matt001k/ANIMIO/ANIMAPP/OBJECTS/Home.png

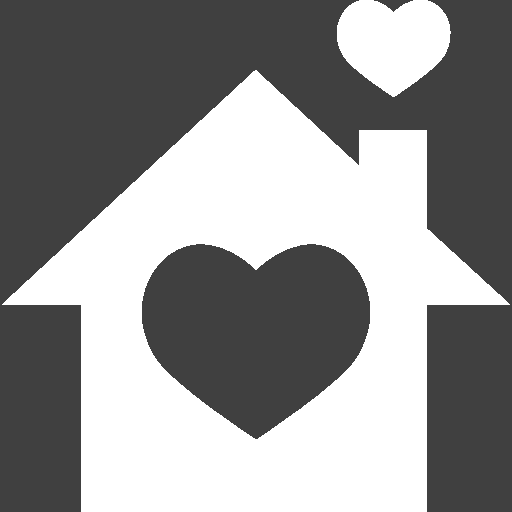
ANIMAPP/OBJECTS/Home.png
