matt001k/ANIMIO/ANIMAPP/OBJECTS/Phone.png

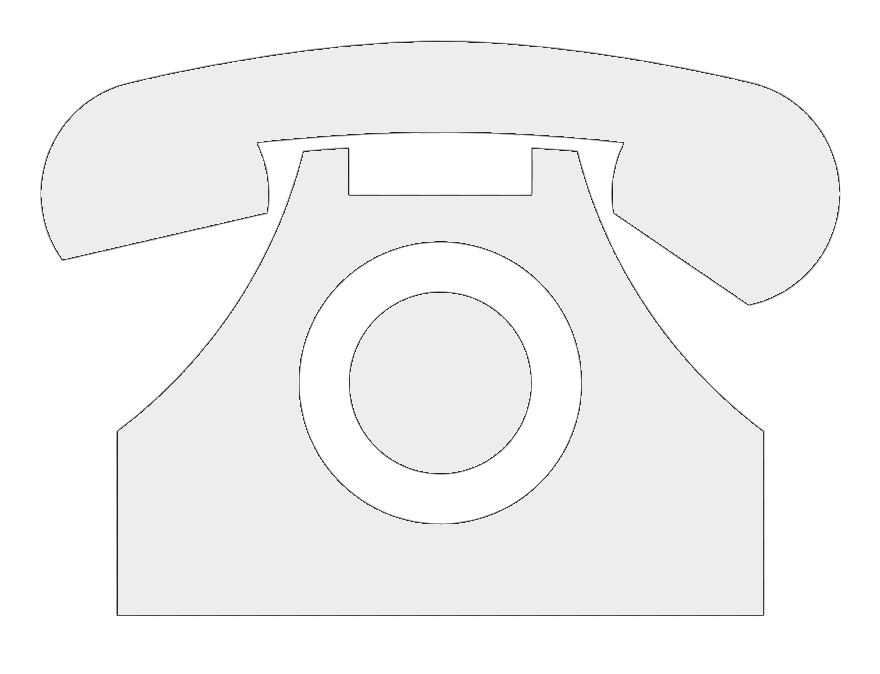
ANIMAPP/OBJECTS/Phone.png
