matt001k/ANIMIO/ANIMAPP/OBJECTS/Settings.png

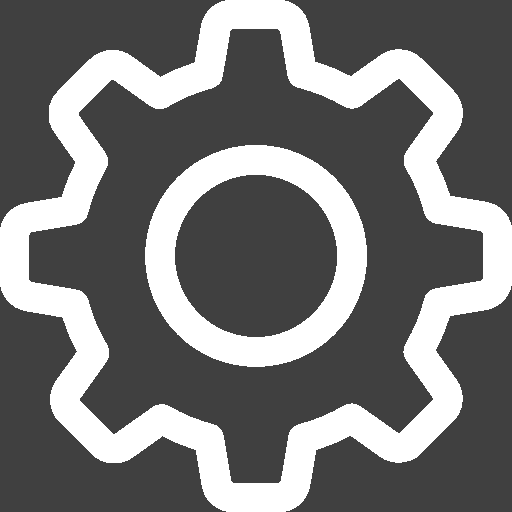
ANIMAPP/OBJECTS/Settings.png
