matt001k/ANIMIO/Images/Libraries.PNG

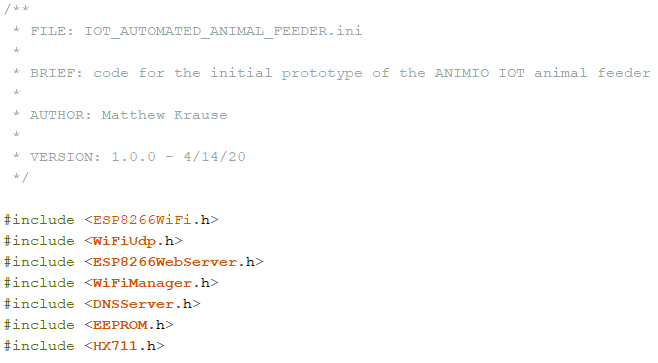
Images/Libraries.PNG
