matt001k/ANIMIO/Images/valve assem.jpg

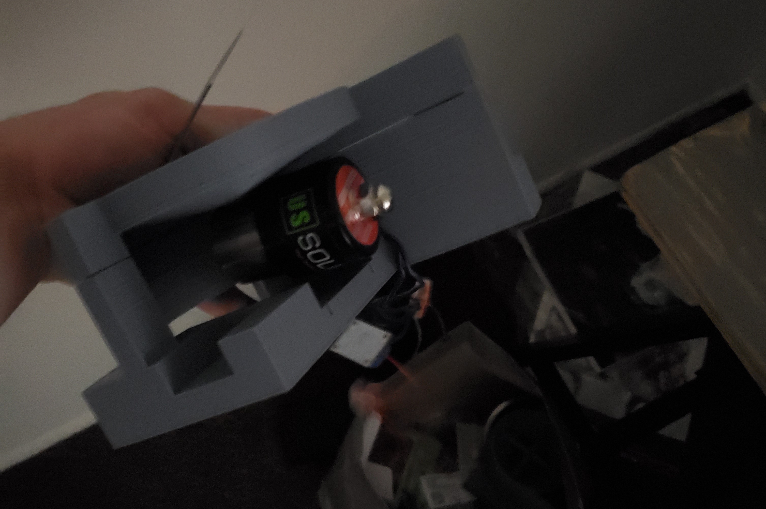
Images/valve assem.jpg
