matt001k/ANIMIO/Materials/Bill of Materials(ANIMIO).pdf

Assembly Name : Components List Approval Date :
Part Count : | 13
Total Cost : | $119.51
Part # | Part Name | Description | Qty | Manufacturer | Website Link: | Documentation | Unit Cost | Cost
SEN-13329 | Load Cell | 40-50kg max load | 2 | SparkFun | https://www.digikey.com/pr oduct-detail/en/sparkfun- (https://www.digikey.com/product-detail/en/sparkfun-electronics/SEN-13329/1568-1852-ND/7393715)
$ | 8.50 | $ 17.00
WRL-13804 | SparkFun ESP8266 Thing -Dev Board(With Headers) | Designed around ESP8266 Microcontroller | 1 | SparkFun | https://www.digik (https://www.digikey.com/product-detail/en/sparkfun-electronics/SEN-13329/1568-1852-ND/7393715)ey.com/pr oducts/en?keywords=WRL- (https://www.digikey.com/products/en?keywords=WRL-13804)
$ | 17.95 | $ 17.95
FIT0495-G | Geared Motor | 6V, 162RPM, 1.2Kg/Cm | 1 | DFRobot | https:/ (https://www.digikey.com/products/en?keywords=WRL-13804)/www.digikey.com/pr
oduct- (https://www.digikey.com/product-detail/en/dfrobot/FIT0495-G/1738-1285-ND/7087182)
$ | 10.00 | $ 10.00
JFSV00065 | Solenoid Valve | Stainless Steel, 1/4" inlet and outlet port, 12VDC | 1 | USSOLID | https://www.amazon.com/ (https://www.digikey.com/product-detail/en/dfrobot/FIT0495-G/1738-1285-ND/7087182)U- S-Solid-Stainless-Electric- (https://www.amazon.com/U-S-Solid-Stainless-Electric-Solenoid/dp/B00APD49BS)
$ | 28.00 | $ 28.00
ROB-14450 | Motor Driver Board | TB6612FNG IC, PWM Control | 1 | SparkFun | https://www.digikey.com/pr (https://www.amazon.com/U-S-Solid-Stainless-Electric-Solenoid/dp/B00APD49BS) oduct-detail/en/sparkfun- (https://www.digikey.com/product-detail/en/sparkfun-electronics/ROB-14450/1568-1755-ND/7915576)
$ | 5.45 | $ | 5.45
SEN-13879 | HX711 Load Cell Amplifier | Module designed around HX711 | 2 | SparkFun | https://www.digik (https://www.digikey.com/product-detail/en/sparkfun-electronics/ROB-14450/1568-1755-ND/7915576)ey.com/pr oduct-detail/en/sparkfun- (https://www.digikey.com/product-detail/en/sparkfun-electronics/SEN-13879/1568-1436-ND/6202732)
$ | 9.95 | $ 19.90
L6R36-120 | Power Supply | 12V,36W,Wall Mounted | 1 | Tri-Mag, LLC | https://www.digik (https://www.digikey.com/product-detail/en/sparkfun-electronics/SEN-13879/1568-1436-ND/6202732)ey.com/pr oduct-detail/en/tri-mag- (https://www.digikey.com/product-detail/en/tri-mag-llc/L6R36-120/364-1282-ND/7682645)
$ | 10.16 | $ 10.16
PJ-202AH | DC Power Jack Male | Rated 5A,24Vdc | 1 | CUI Devices | https://www.digikey.com/ (https://www.digikey.com/product-detail/en/tri-mag-llc/L6R36-120/364-1282-ND/7682645)pr oduct-detail/en/cui- (https://www.digikey.com/product-detail/en/cui-devices/PJ-202AH/CP-202AH-ND/408450)
$ | 0.74 | $ | 0.74
COM-15208 | Buck-Boost Converter | 3-16V Input, 2.5-9V Output, 2A Output Current | 1 | SparkFun | https://www.digikey.com (https://www.digikey.com/product-detail/en/cui-devices/PJ-202AH/CP-202AH-ND/408450)/pr oduct-detail/en/sparkfun- (https://www.digikey.com/product-detail/en/sparkfun-electronics/COM-15208/1568-COM-15208-ND/10187090)
$ | 10.31 | $ 10.31
VMA-406 | Relay | 5V Input, 120VAC Output,SPDT
1 | Velleman | Currently On hand | $ | -
VMA-301 | Real Time Clock | With Backup Battery | 1 | Velleman | Currently On hand | $ | -
$ | -
$ | -
$ | -
$ | -
$ | -
$ | -
$ | -
$ | -
| Total | | 13 | | | | | $ 119.51

# IOT Automated Animal Feeder

FIT0495-G_Web.pdf Solenoid Valve Data.JPG TB6612FNG Datasheet.pdf | TB6612FNG Hookup Guide.pdf SparkFun_HX711_Load_Cell_v11.pdf | hx711_english.pdf ESP8266ThingDevV1.pdf | L6R36-L6R48 Series Datasheet.pdf PJ-202AH Datasheet.pdf COM-15208 Datasheet.pdf | TPS63070 Datasheet.pdf | Buck-Boost_Hookup_Guide_.pdf vma406 Datasheet.pdf vma301 Datasheet.pdf | ds1302 Datasheet.pdf
