matt001k/ANIMIO/Materials/Datasheets/JFSV00065 - Solenoid Valve/Solenoid Valve Data.JPG

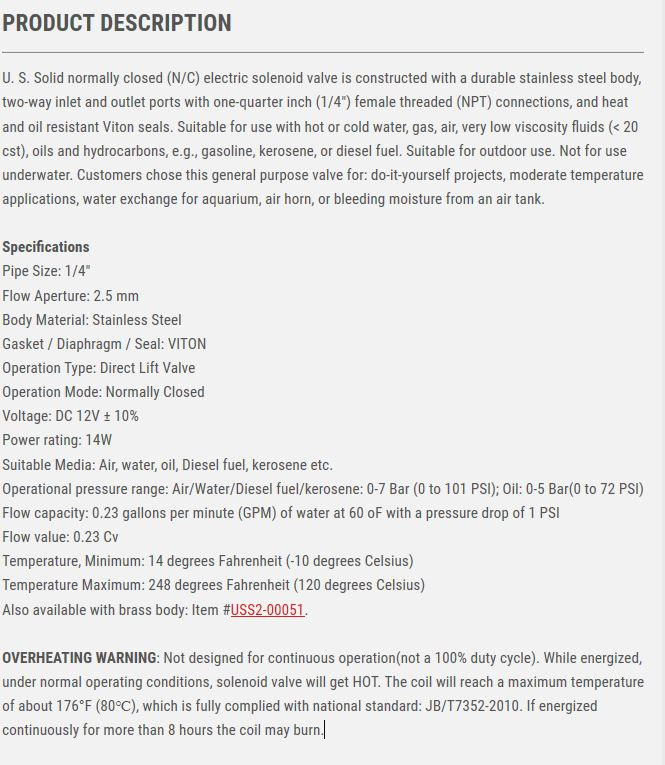
Materials/Datasheets/JFSV00065 - Solenoid Valve/Solenoid Valve Data.JPG
