matt001k/ANIMIO/Schematics/Mechanical Schematics/001003M(ANIMIO ASSEMBLY).pdf

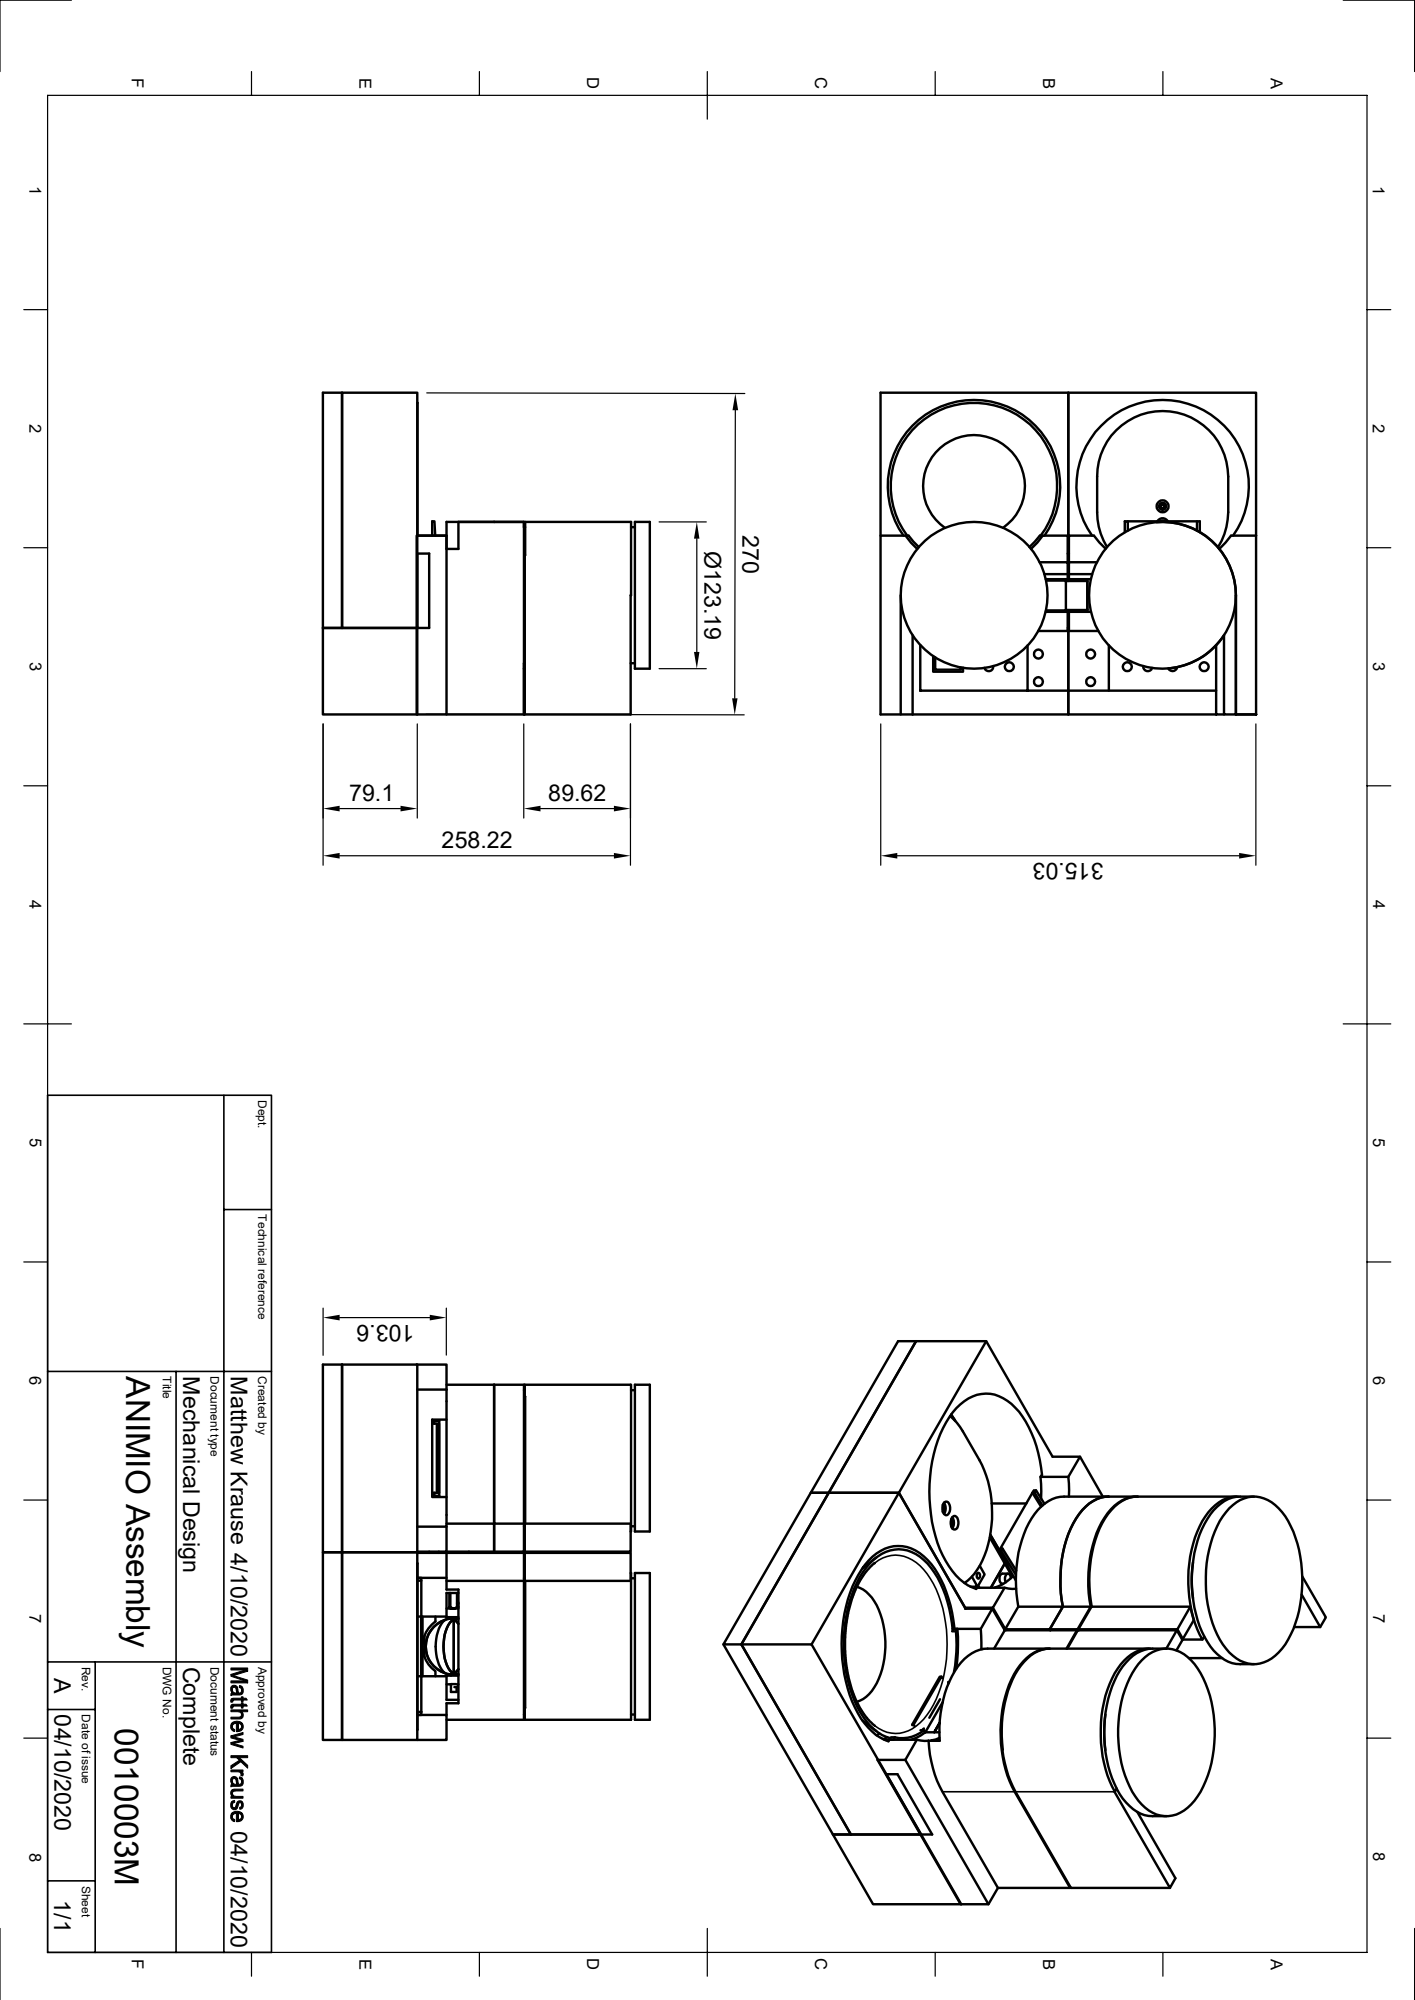
[picture p25: page 1]

1 A 2 3 4 5 6 7 8 1 2 3 4 5 6 7 8 FEDCB FEDCBA Dept. Technical reference Created by Approved by Title DWG No. Document type Document status Rev. Date of issue Sheet 04/10/2020 AComplete Mechanical Design 04/10/2020 4/10/2020 1/1 0010003M ANIMIO Assembly Matthew Krause
