matt001k/ANIMIO/Schematics/Electrical Schematics/999810(IOT AUTOMATED ANIMAL FEEDER)-REV B.pdf

L
N

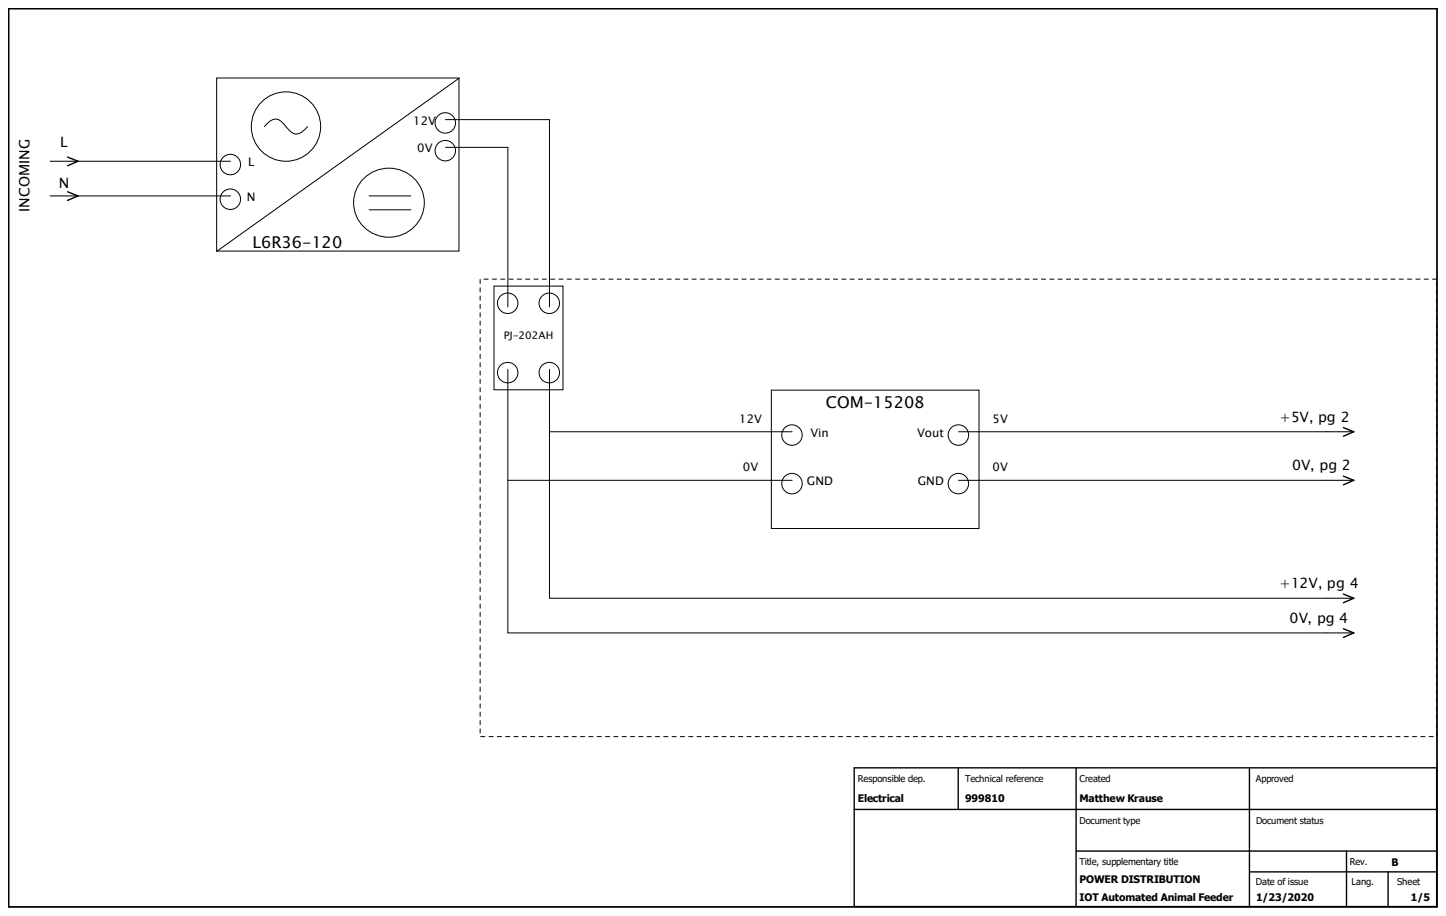
[picture p26: page 1]
N INCOMING; Vin; GND; Vout; COM-15208; Responsible dep. Electrical; Technical reference 999810; Created Matthew Krause; Approved; Document type; Document status

Title, supplementary title POWER DISTRIBUTION IOT Automated Animal Feeder | | Rev. B
Date of issue 1/23/2020 | Lang. | Sheet 1/5

# ESP8266

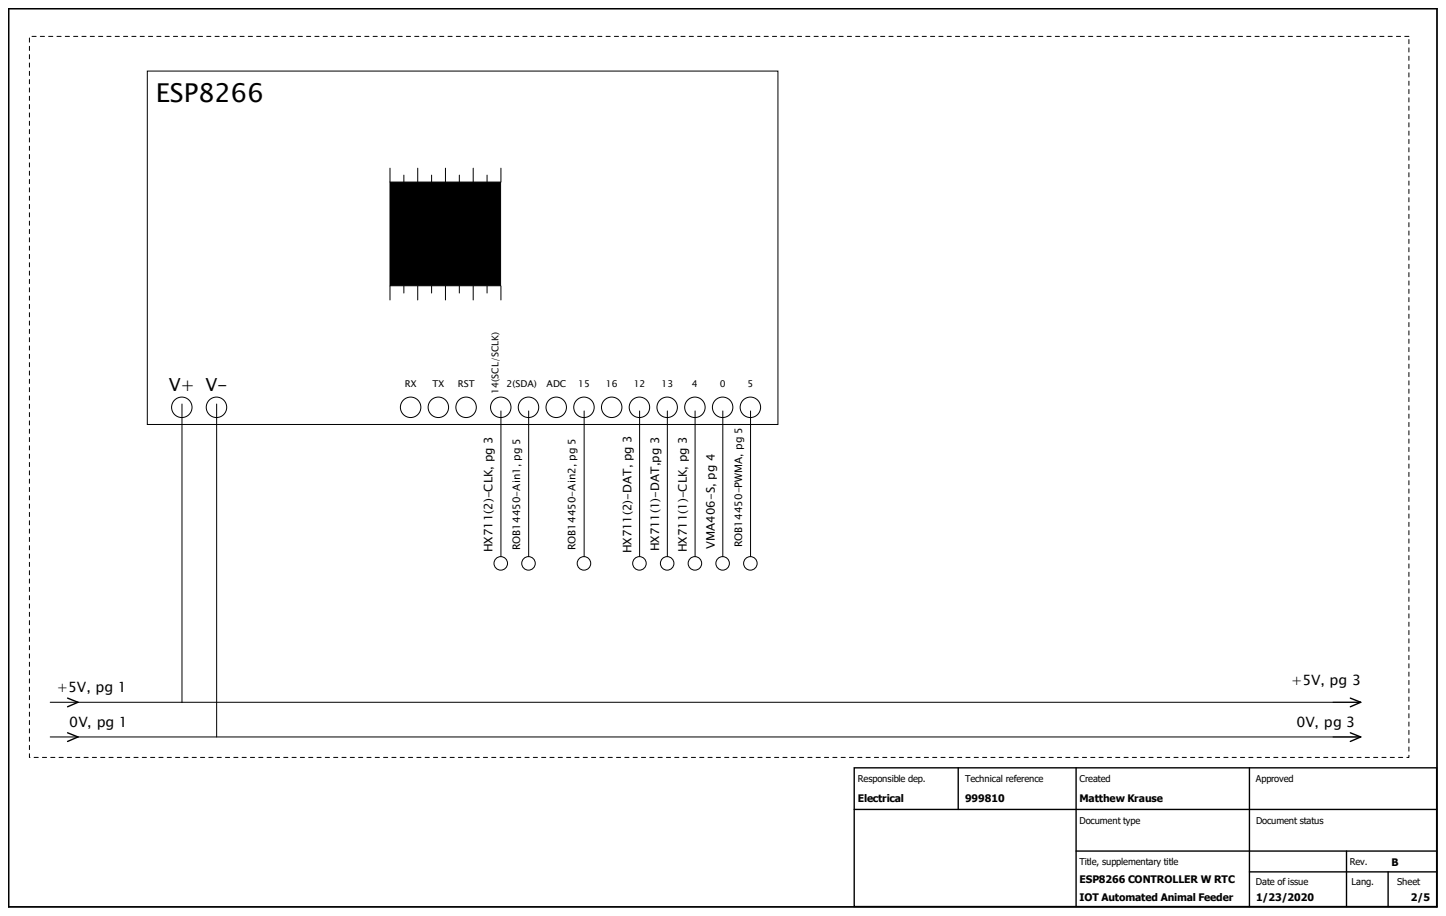
[picture p27: page 2]
0V, pg 3 HX711⁽2⁾-CLK, pg 3; ROB14450-Ain1, pg 5; ROB14450-Ain2, pg 5; HX711⁽2⁾-DAT, pg 3; HX711⁽1⁾-DAT,pg 3; HX711⁽1⁾-CLK, pg 3; VMA406-S, pg 4; ROB14450-PWMA, pg 5; 2(SDA) ADC 15 16 12 13; 5 14⁽SCL/SCLK⁾ RX TX RST; Responsible dep. Electrical; Technical reference 999810; Created Matthew Krause; Approved; Document type; Document status

ESP8266 CONTROLLER W RTC IOT Automated Animal Feeder | Rev. B

### RED BLK

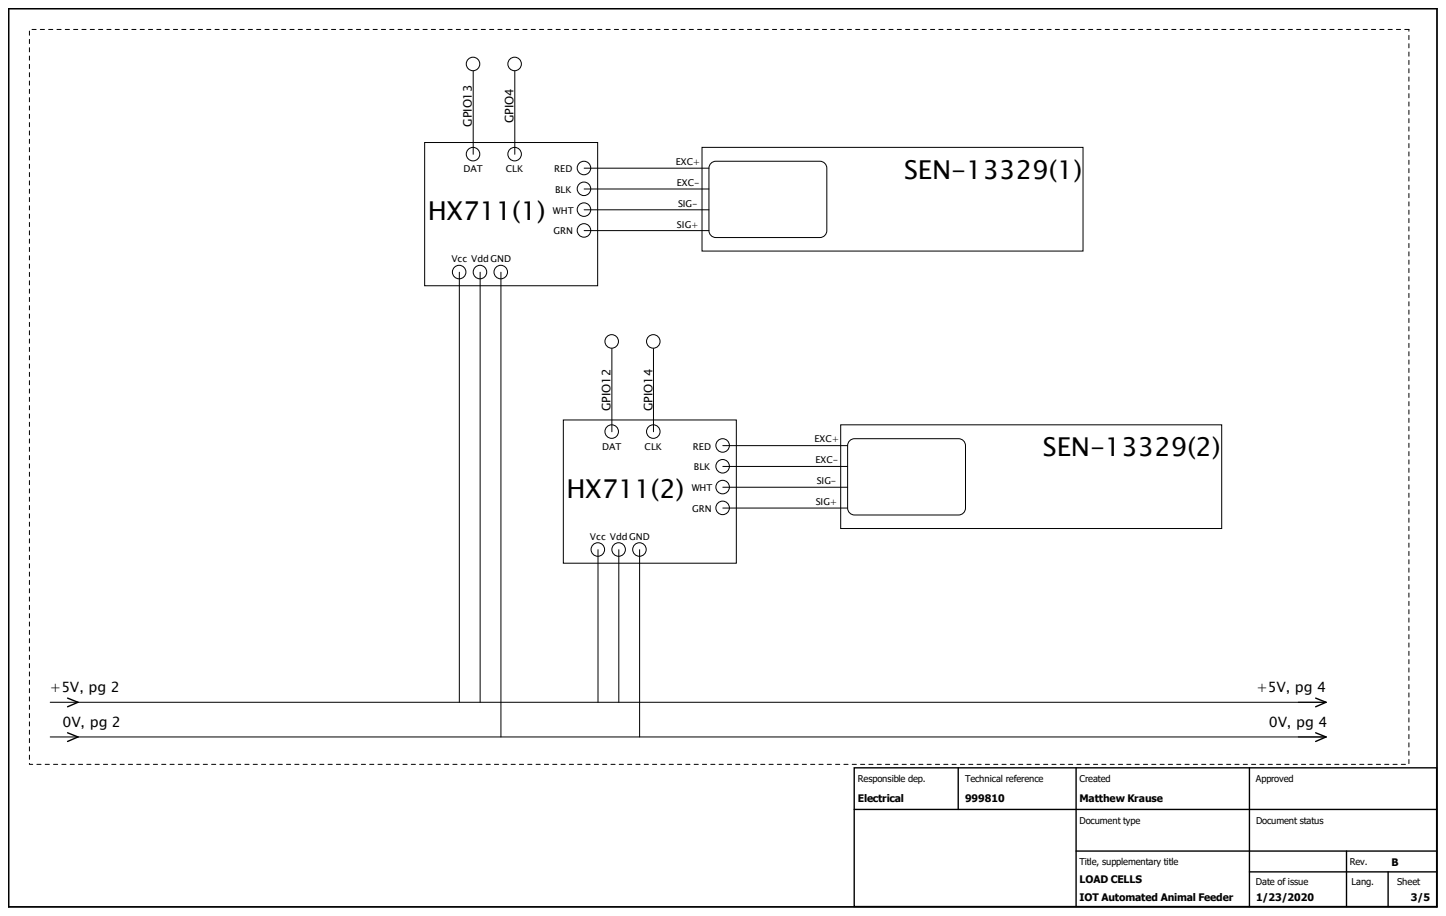
[picture p28: page 3]
Vcc VddGND; WHT GRN; RED BLK WHT GRN; DAT; CLK; SEN-13329(1); SEN-13329(2) GPIO¹³; GPIO⁴; GPIO¹²; GPIO¹⁴; EXC+; SIG+; EXC- SIG-; Responsible dep. Electrical; Technical reference 999810; Created Matthew Krause; Approved; Document type; Document status

LOAD CELLS IOT Automated Animal Feeder | Rev. B

S
NC

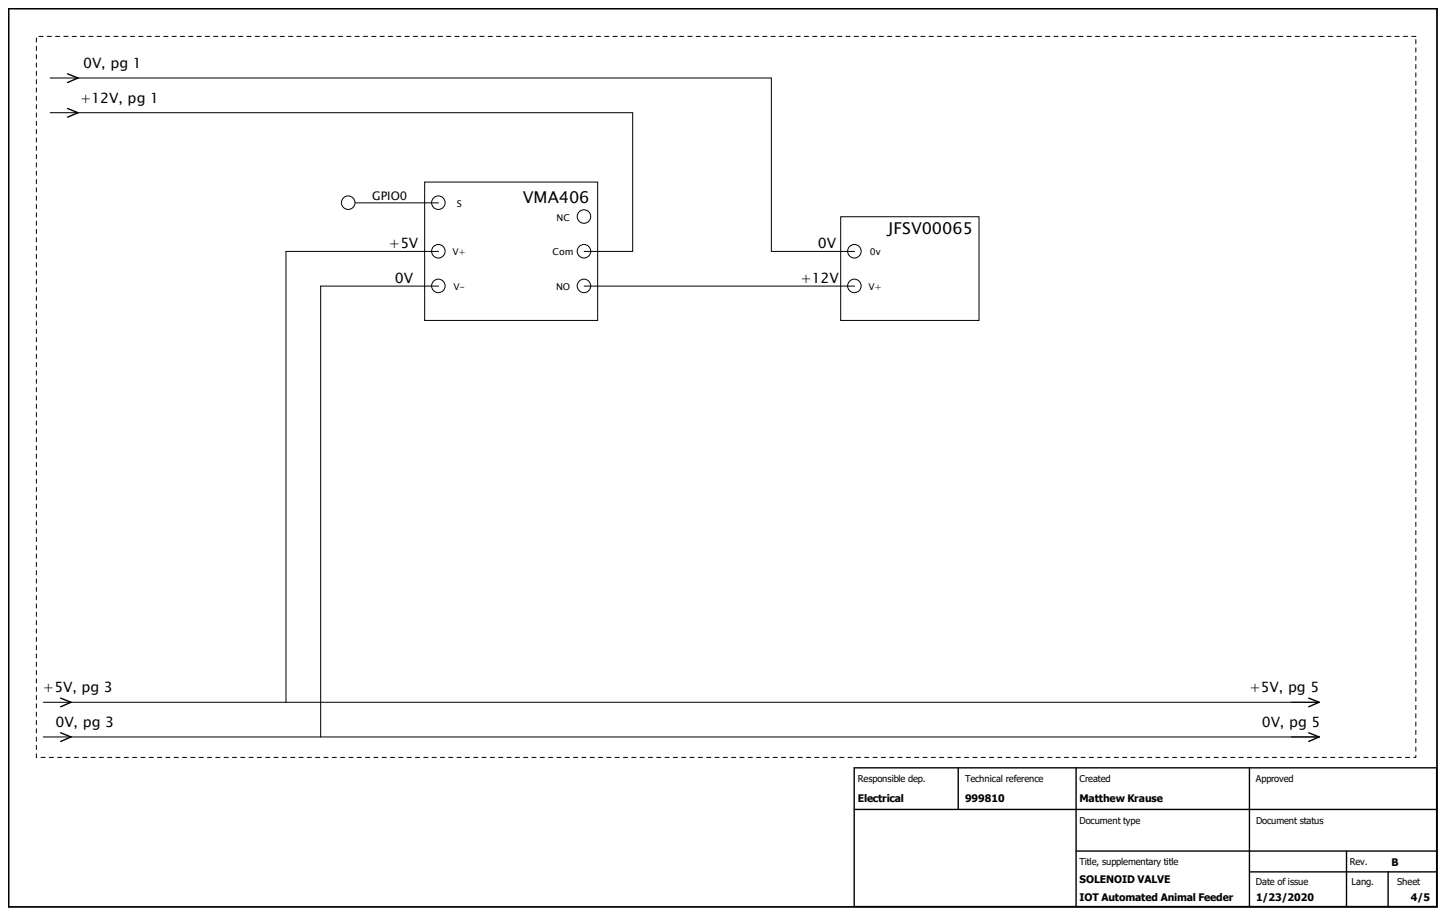
[picture p29: page 4]
Com; GPIO0; VMA406; JFSV00065; Responsible dep. Electrical; Technical reference 999810; Created Matthew Krause; Approved; Document type; Document status

SOLENOID VALVE IOT Automated Animal Feeder | Rev. B

V-
ROB-14450 | FIT0495-G

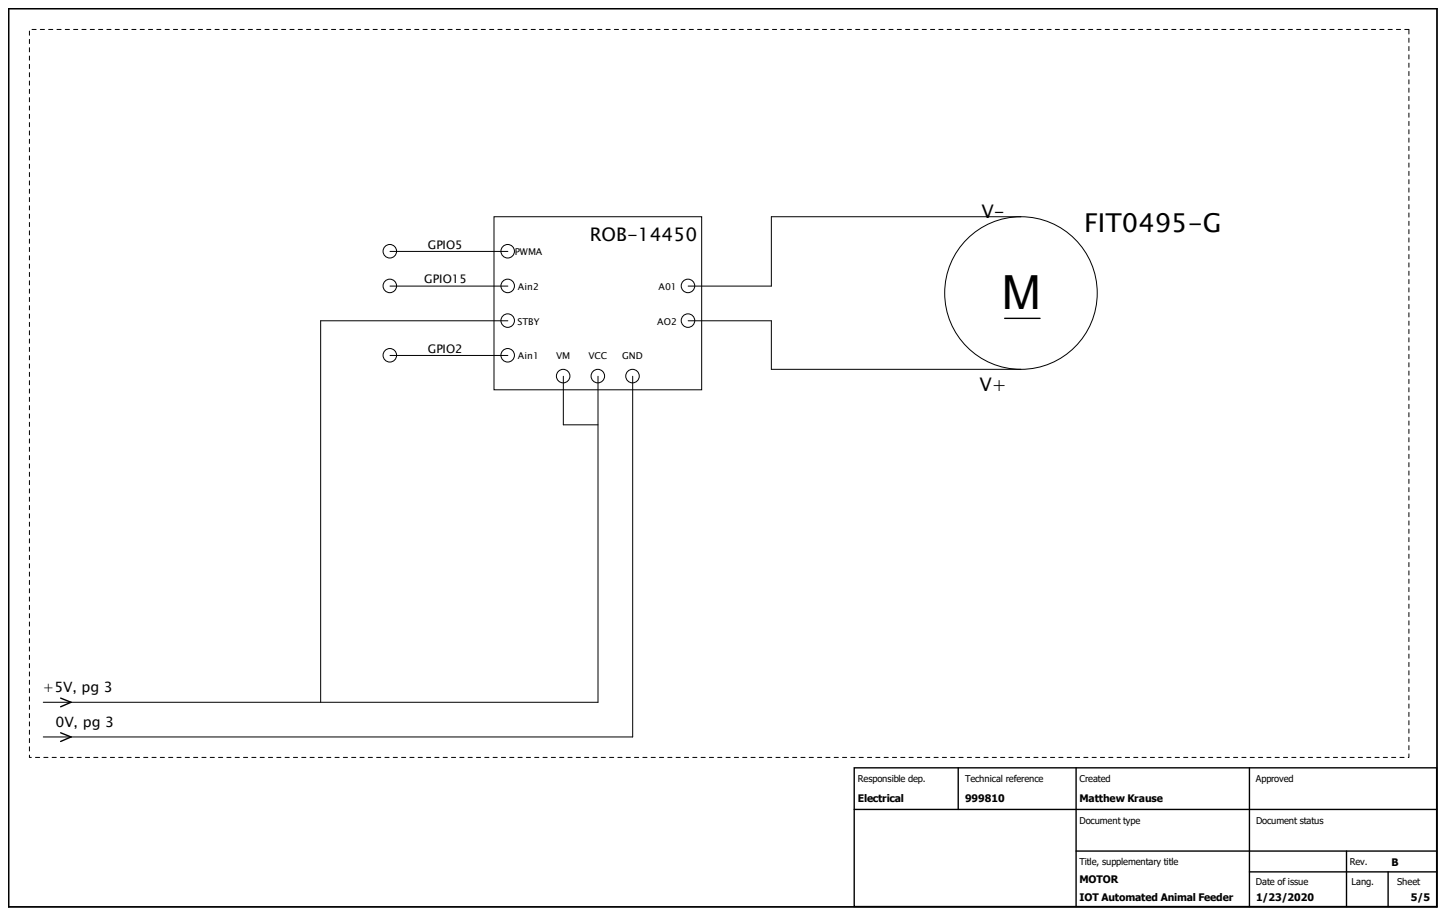
[picture p30: page 5]
PWMA; Ain2; Ain1; STBY; VCC GND; GPIO5; GPIO15; GPIO2; Responsible dep. Electrical; Technical reference 999810; Created Matthew Krause; Approved; Document type; Document status

MOTOR IOT Automated Animal Feeder | Rev. B
